coelusarne/CogniWake/docs/BreadboardView.png

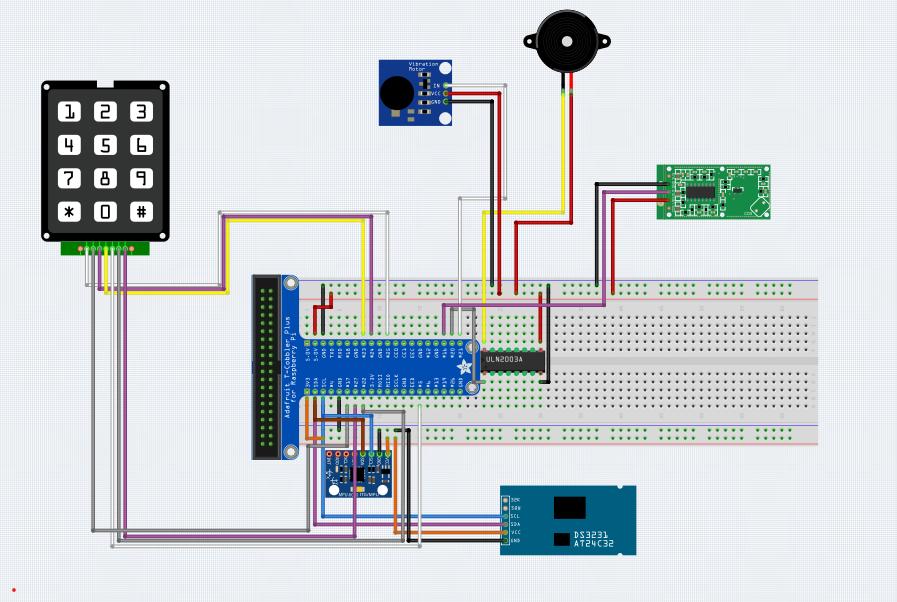
docs/BreadboardView.png
