coelusarne/CogniWake/code/readme.md

# CogniWake                     

**VOORNAAM NAAM:** Arne Coelus

**Sparringpartner:** Rémy Vancayseele

**Projectsamenvatting in max 10 woorden:** Wekker die cognitieve functie nodig heeft voor uit te gaan.

**Projecttitel:** 

Annoying alarm clock

**Korte omschrijving van het project**

Een wekker die voor te deactiveren een correcte invoer op een wiskundig probleem eist. 
Deze wekker is uitgerust met verschillende sensoren en is op de hoogte van zijn omgeving.
