coelusarne/CogniWake/docs/SchematicView.png

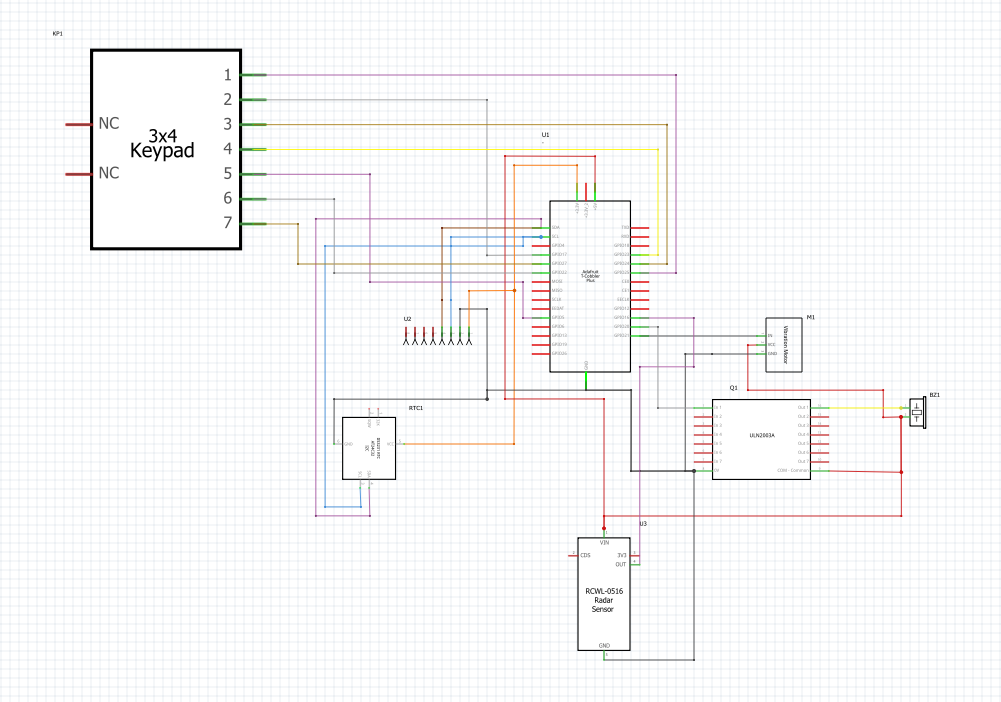
docs/SchematicView.png
