coelusarne/CogniWake/docs/BOM.pdf

Part Count : | 17
Total Cost : | €130
Part # | Part Name | Description | Revision | Qty
1 | Raspberry Pi 4B 1G or equivelant | Raspberry Pi to control the system.
1 | 1
2 | Raspberry Pi 27W USB-C
Power Supply Unit

Power supply to power
the device.
1 | 1
3 | Assembled T-Piece Cobbler | Used for easily exposing the pi's pins
1 | 1
4 | Half-size breadboard | For connecting the components
1 | 1
5 | MPU-6050
accelerometer/gyroscope

Detecs if the device is
moved.
1 | 1
6 | RCWL-0516 Movement detector Detects movement in
front of the device.
1 | 1
7 | Keypad matrix 3 x 4 | Used for input on the device.
1 | 1
8 | 15 Pin to 15 Pin DSI Cable | 15 Pin DSI cable for the display
1 | 1
9 | Raspberry Pi Touch Display 2 5"
Screen Size
Display for the device. | 1 | 1
10 | ULN2003 Darlington Array | Responsible for driving the buzzer.
1 | 1

11 | SFM-27-I Active Buzzer | Makes noise for the device.
1 | 1
12 | Vibration motor module | Makes the device vibrate. | 1 | 1
13 | DS3231 RTC Module | Stores the real time. | 1 | 1
14 | PLA | Required for 3D Printing the enclosure.
1 | 1
15 | 8 x M2.5 Screws | Required for mounting the Pi and Display Included with the Display
1 | 1
16 | 4 x Rubber foot pads | For keeping the device from moving around
1 | 1
17 | 7 x Double-sided adhesive pads Used for mounting
components & keeping
the roof in place
1 | 1
Total | 17

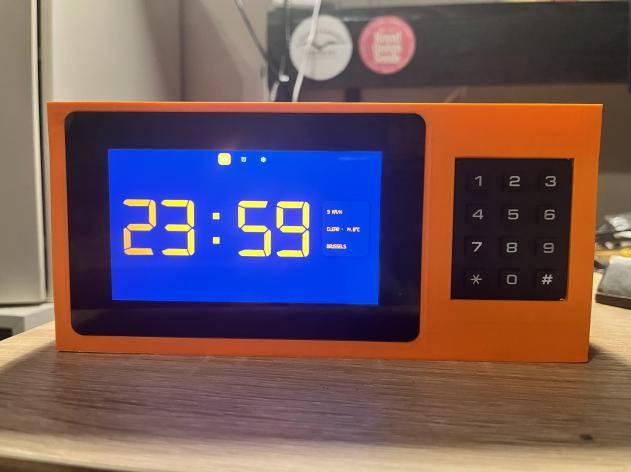
[picture p3: figure]

Supplier | also available from | Units | Unit Cost
| | 1 | 39,95 €
1 | 12,95 €
1 | 7,70 €
1 | 3,00 €
1 | 3,75 €
1 | 1,80 €
https://electropeak.com/3x4-matrix-keypad | 1,28 €
1 | 2,95 €
1 | 42,95 €
https://www.hobbyelectronica.nl/product/uln2003a-darlington-array/ (https://www.bitsandparts.nl/ic-uln2003an-darlington-array-p113669) | 1 | 0,75 €

https://elektronicavoorjou.nl/product/continu-active-buzzer-3-24v-sfm-27/ (https://www.androegg.de/shop/sfm27-piezo-alarm-signal-buzzer-aktiv-3-24-sfm27-i-permanent/) | 1 | 1,17 €
https://www.hobbyelectronica.nl/product/tril-vibratie-dc-motor-module-v3-7-5-3/ https://elektronicavoorjou.nl/product/pwm-vibratie-motor-5v/ 1 | 2,45 €
1 | 3,95 €

Max Cost Real Cost
€ 39,95 | € 39,95
€ 12,95 | € 12,95
€ 16,00 | € | 7,70
€ | 3,62 | € | 3,00
€ | 3,75 | € | 3,75
€ | 1,80 | € | 1,80
€ | 1,28 | € | 1,28
€ | 2,95 | € | 2,95
€ 42,95 | € 42,95
€ | 0,75 | € | 0,75

€ | 1,17 | € | 1,17
€ | 2,45 | € | 2,45
€ | 3,95 | € | 3,95

€ 129,62
