coelusarne/CogniWake/3D/Mainbody.stl

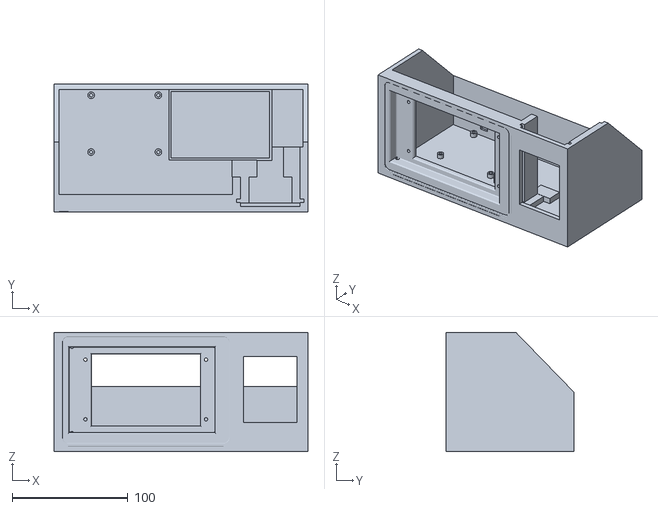
[picture p4: CAD file, 2026-06-17]
3D/Mainbody.stl
219.0 x 110.0 x 103.0
