coelusarne/CogniWake/3D/BodyRoof.stl

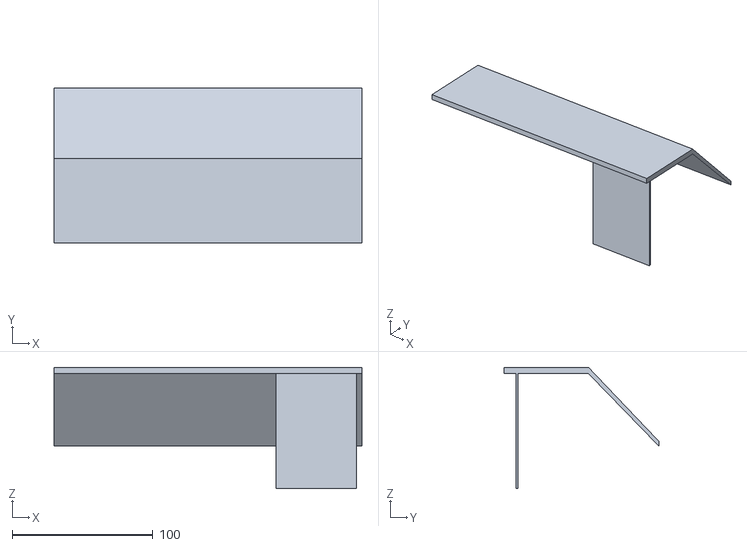
[picture p5: CAD file, 2026-06-17]
3D/BodyRoof.stl
219.0 x 110.0 x 86.2
