coelusarne/CogniWake/(commit log)

2026-06-17 image + BOM/wiring references
2026-06-17 Enclosure model
    [BodyRoof.stl, Mainbody.stl]
